AtainEndevor/ARC/ARC Project/20150724_220627.jpg

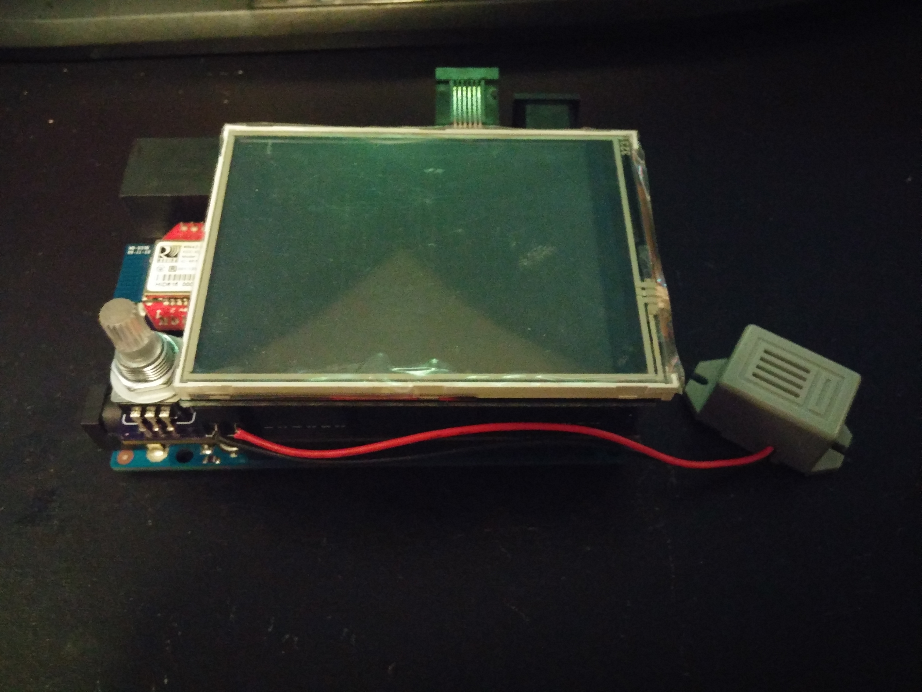
ARC Project/20150724_220627.jpg
