AtainEndevor/ARC/ARC Project/20150724_220816.jpg

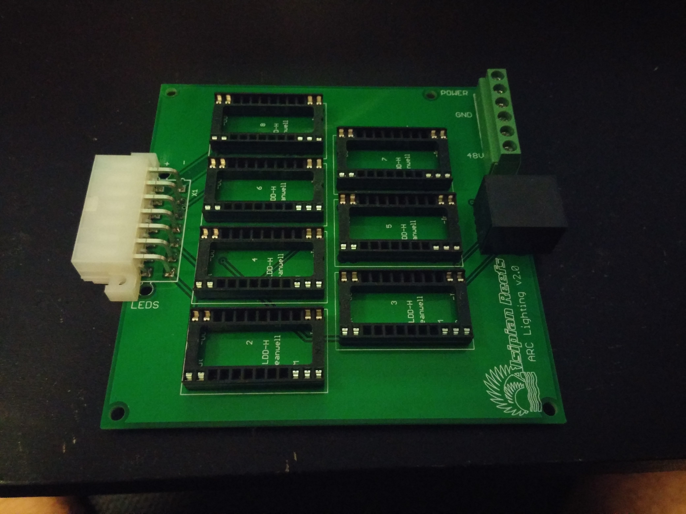
ARC Project/20150724_220816.jpg
