AtainEndevor/ARC/ARC Project/20150724_220504.jpg

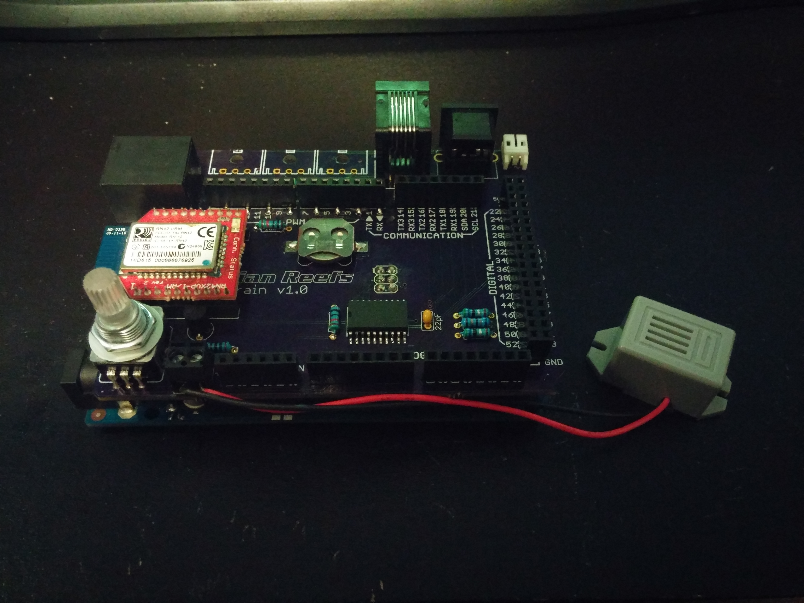
ARC Project/20150724_220504.jpg
