AtainEndevor/ARC/ARC Project/20150724_220649.jpg

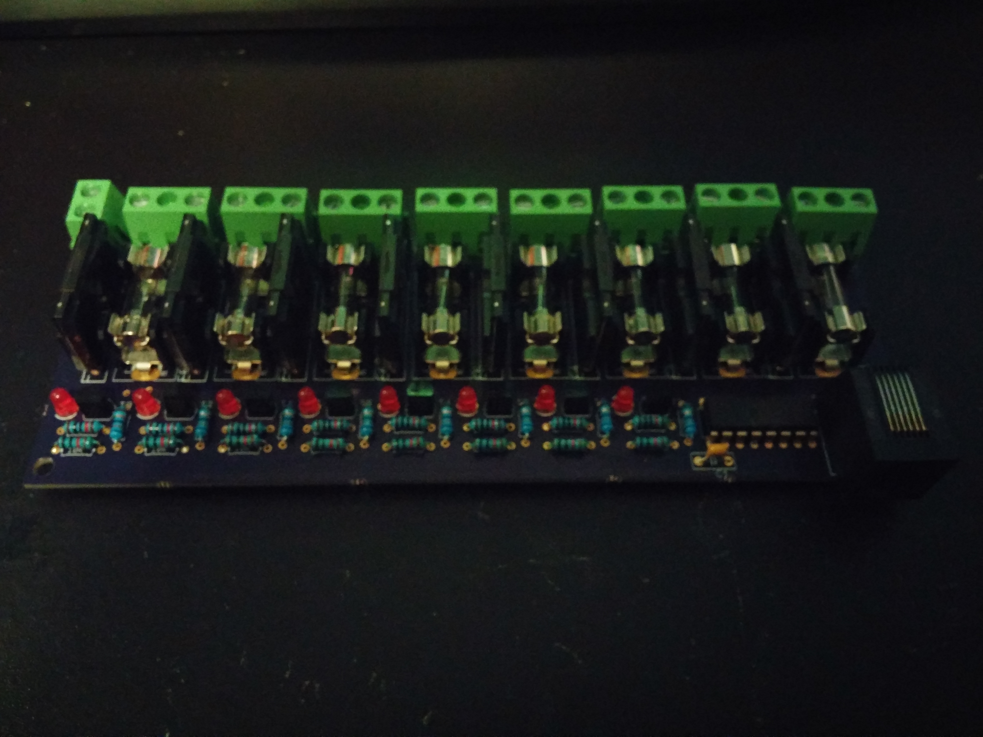
ARC Project/20150724_220649.jpg
