AtainEndevor/ARC/ARC Project/20150724_220824.jpg

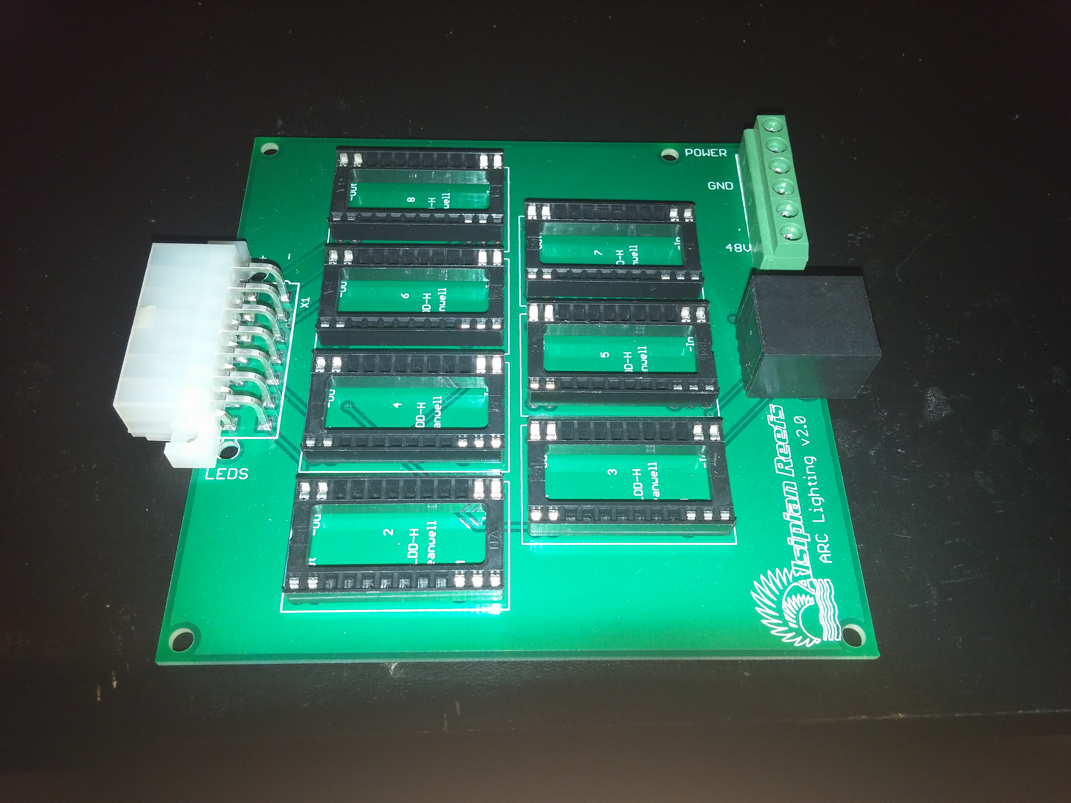
ARC Project/20150724_220824.jpg
