AtainEndevor/ARC/ARC Project/Dosing.png

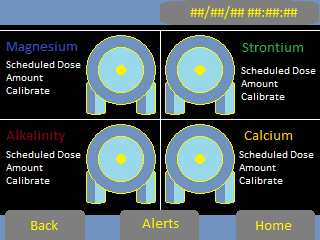
ARC Project/Dosing.png
