AtainEndevor/ARC/ARC Project/Home Page.png

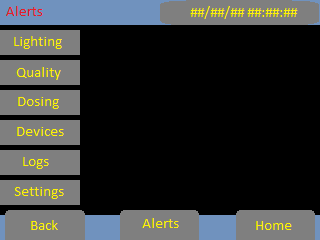
ARC Project/Home Page.png
