AtainEndevor/ARC/ARC Project/Lighting.png

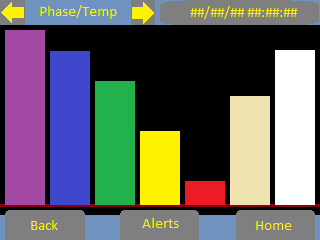
ARC Project/Lighting.png
