AtainEndevor/ARC/ARC Project/Power Outlets.png

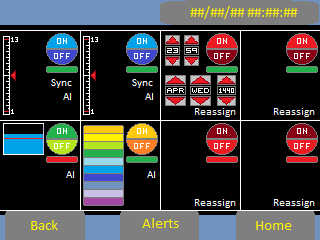
ARC Project/Power Outlets.png
