AtainEndevor/ARC/ARC Project/Quality.png

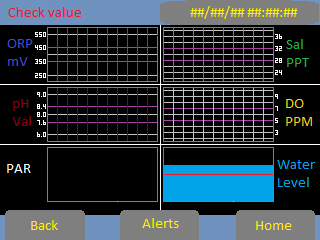
ARC Project/Quality.png
