AtainEndevor/ARC/ARC Project/Template.png

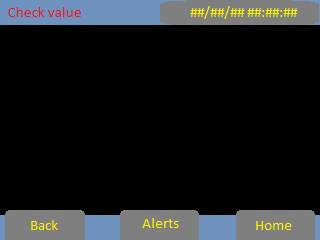
ARC Project/Template.png
