AtainEndevor/ARC/ARC Project/Alsipian_Reefs_Logo.dxf

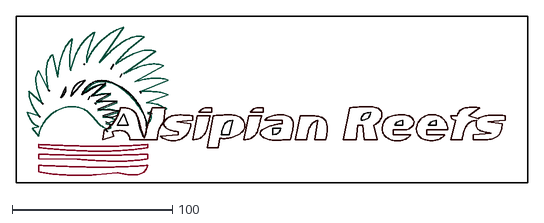
[picture p12: CAD file, 2020-02-04]
ARC Project/Alsipian_Reefs_Logo.dxf
319.0 x 104.0
