AtainEndevor/ARC/ARC Project/Alsipian Reefs Logo-Original (BW).dxf

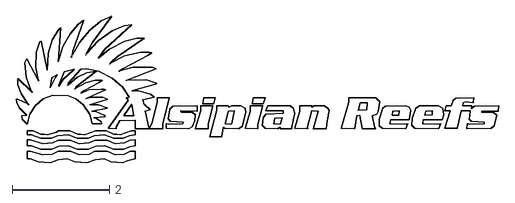
[picture p13: CAD file, 2020-02-04]
ARC Project/Alsipian Reefs Logo-Original (BW).dxf
9.92 x 3.01
