AtainEndevor/ARC/ARC Project/ARC Shield/ARC Shield 0.2.brd

## EAGLE design ARC Project/ARC Shield/ARC Shield 0.2.brd (2020-02-04)

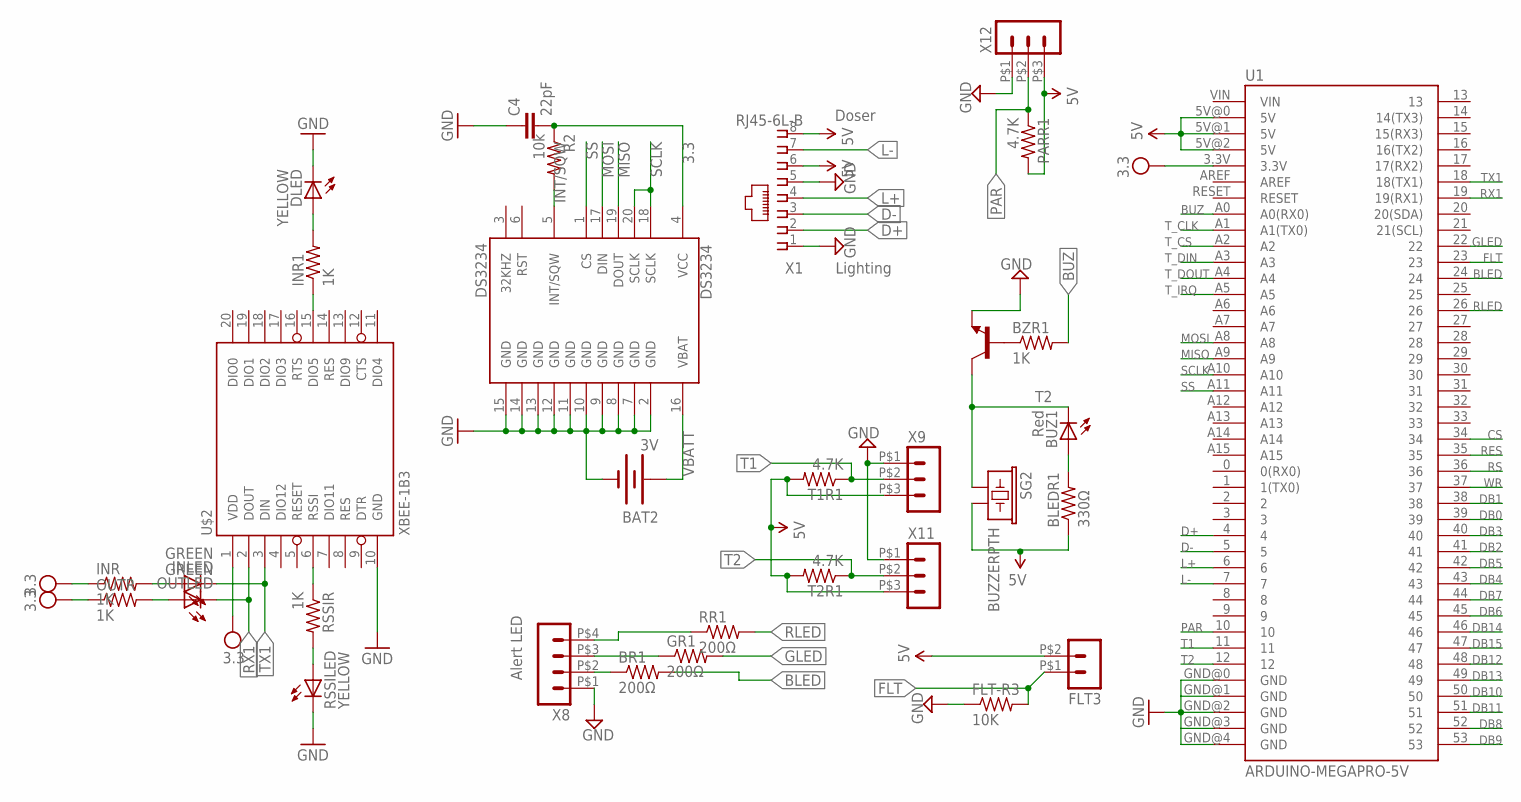
[picture p14: schematic ARC Shield 0.2.sch]

Parts:
BAT2: 3V; BATTCON_12MM_CURVED
BLEDR1: 330Ω; 0204/7
BR1: 200Ω; 0204/7
BUZ1: Red; LED3MM
BZR1: 1K; 0204/7
C4: 22pF; C5B3
DLED: YELLOW; LED3MM
DS3234: DS3234
FLT3: HEADER_POS2_43045-0200; 43045-0200
FLT-R3: 10K; 0204/7
GR1: 200Ω; 0204/7
INLED: GREEN; LED3MM
INR, INR1: 1K; 0204/7
OUTLED: GREEN; LED3MM
OUTR: 1K; 0204/7
PARR1: 4.7K; 0204/7
R2: 10k; 0204/7
RR1: 200Ω; 0204/7
RSSILED: YELLOW; LED3MM
RSSIR: 1K; 0204/7
SG2: BUZZERPTH; BUZZER-12MM
T1R1, T2R1: 4.7K; 0204/7
T2: -NPN-TO92; TO92
U1: ARDUINO-MEGAPRO-5V; ARDUINO_MEGA-PRO-5V
U$2: XBEE-1B3; XBEE-SMD
X1: RJ45-6L-B; RJ45-NO-SHIELD
X8: HEADER_POS4_43045-0401; 43045-0400
X9, X11, X12: HEADER_POS3_43650-0300; 43650-0300

Connections:
3.3: C4.2, DS3234.4 (VCC), R2.1, U$2.1 (VDD)
5V: BLEDR1.1, FLT3.P$2 (2), PARR1.2, SG2.- (2), T1R1.2, T2R1.2, U1.5V@0 (5V), U1.5V@1 (5V), U1.5V@2 (5V), X1.6, X1.8, X9.P$3 (3), X11.P$3 (3), X12.P$3 (3)
BLED: BR1.2, U1.24
BUZ: BZR1.2, U1.A0 (A0(RX0))
CS: U1.34
D+: U1.4, X1.2
D-: U1.5, X1.3
DB0: U1.39
DB1: U1.38
DB2: U1.41
DB3: U1.40
DB4: U1.43
DB5: U1.42
DB6: U1.45
DB7: U1.44
DB8: U1.52
DB9: U1.53
DB10: U1.50
DB11: U1.51
DB12: U1.48
DB13: U1.49
DB14: U1.46
DB15: U1.47
FLT: FLT3.P$1 (1), FLT-R3.2, U1.23
GLED: GR1.2, U1.22
GND: BAT2.GND (-), C4.1, DLED.K (C), DS3234.2 (GND), DS3234.7 (GND), DS3234.8 (GND), DS3234.9 (GND), DS3234.10 (GND), DS3234.11 (GND), DS3234.12 (GND), DS3234.13 (GND), DS3234.14 (GND), DS3234.15 (GND), FLT-R3.1, RSSILED.K (C), T2.1 (E), U1.GND@0 (GND), U1.GND@1 (GND), U1.GND@2 (GND), U1.GND@3 (GND), U1.GND@4 (GND), U$2.10 (GND), X1.1, X1.5, X8.P$1 (1), X9.P$1 (1), X11.P$1 (1), X12.P$1 (1)
INT/SQW: DS3234.5 (INT/SQW), R2.2
L+: U1.6, X1.4
L-: U1.7, X1.7
MISO: DS3234.19 (DOUT), U1.A9
MOSI: DS3234.17 (DIN), U1.A8
unnamed: BR1.1, X8.P$2 (2)
unnamed: BUZ1.K (C), SG2.+ (1), T2.3 (C)
unnamed: BZR1.1, T2.2 (B)
unnamed: RSSIR.1, U$2.6 (RSSI)
unnamed: GR1.1, X8.P$3 (3)
unnamed: RSSILED.A, RSSIR.2
unnamed: RR1.1, X8.P$4 (4)
unnamed: INLED.A, INR.2
unnamed: OUTLED.A, OUTR.2
unnamed: DLED.A, INR1.2
unnamed: INR1.1, U$2.15 (DIO5)
unnamed: BLEDR1.2, BUZ1.A
PAR: PARR1.1, U1.10, X12.P$2 (2)
RES: U1.35
RLED: RR1.2, U1.26
RS: U1.36
RX1: OUTLED.K (C), U1.19 (19(RX1)), U$2.2 (DOUT)
SCLK: DS3234.18 (SCLK), DS3234.20 (SCLK), U1.A10
SS: DS3234.1 (CS), U1.A11
T1: T1R1.1, U1.11, X9.P$2 (2)
T2: T2R1.1, U1.12, X11.P$2 (2)
TX1: INLED.K (C), U1.18 (18(TX1)), U$2.3 (DIN)
T_CLK: U1.A1 (A1(TX0))
T_CS: U1.A2
T_DIN: U1.A3
T_DOUT: U1.A4
T_IRQ: U1.A5
VBATT: BAT2.PWR@1 (+), DS3234.16 (VBAT)
VCC: INR.1, OUTR.1, U1.3.3V
WR: U1.37

Notes on the sheet:
Doser
Alert LED
Lighting

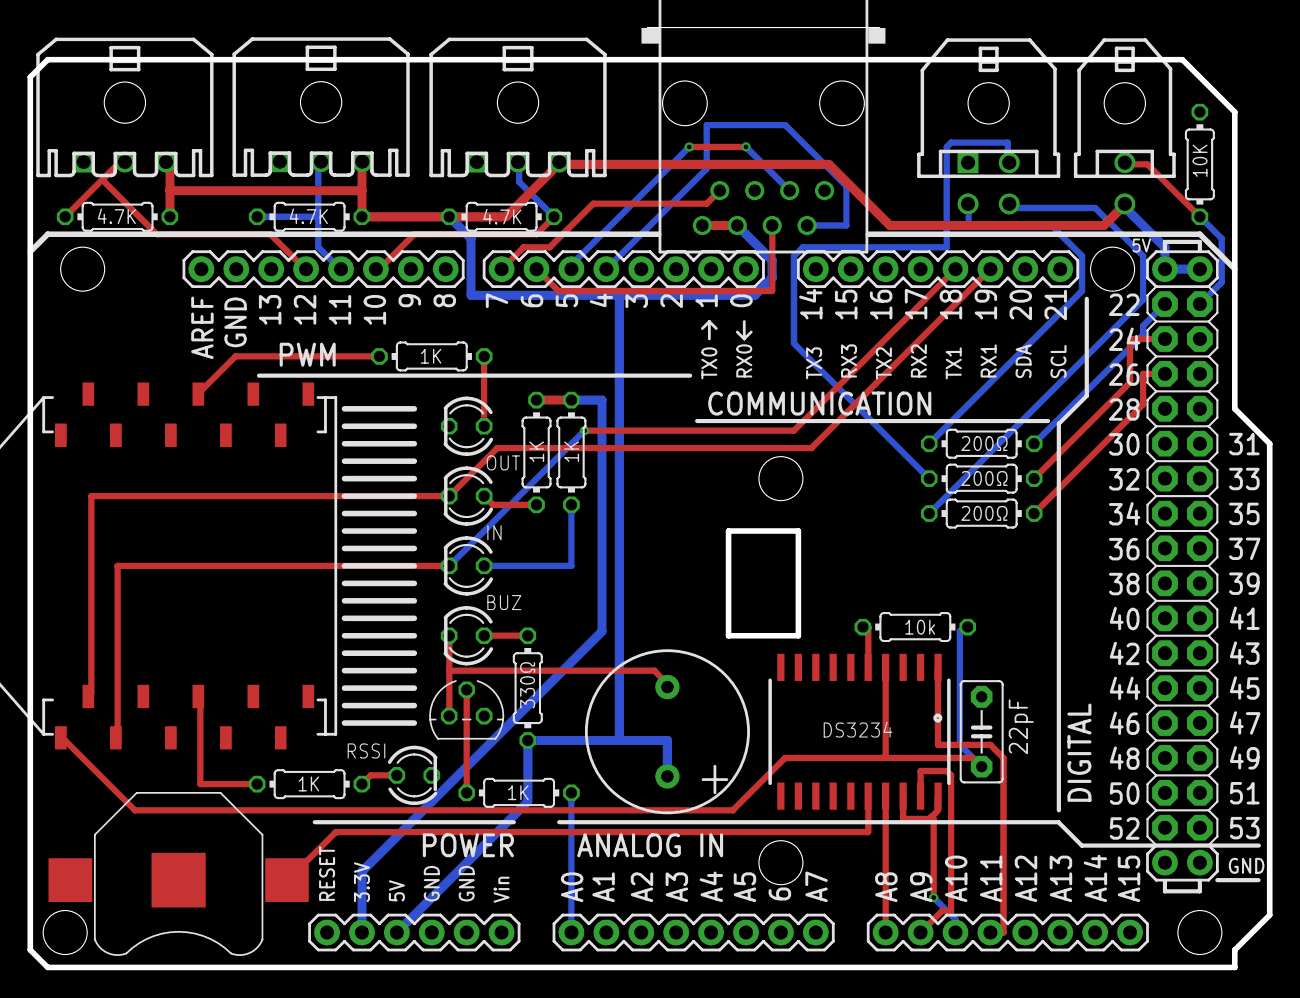
[picture p15: board ARC Shield 0.2.brd from above]

Board: 2 copper layers, 90.2 x 68.4 mm, 32 parts (0 on the bottom side), 36 nets.
