AtainEndevor/ARC/ARC Project/ARC Lighting/ARC Lighting v1.2.brd

## EAGLE design ARC Project/ARC Lighting/ARC Lighting v1.2.brd (2020-02-04)

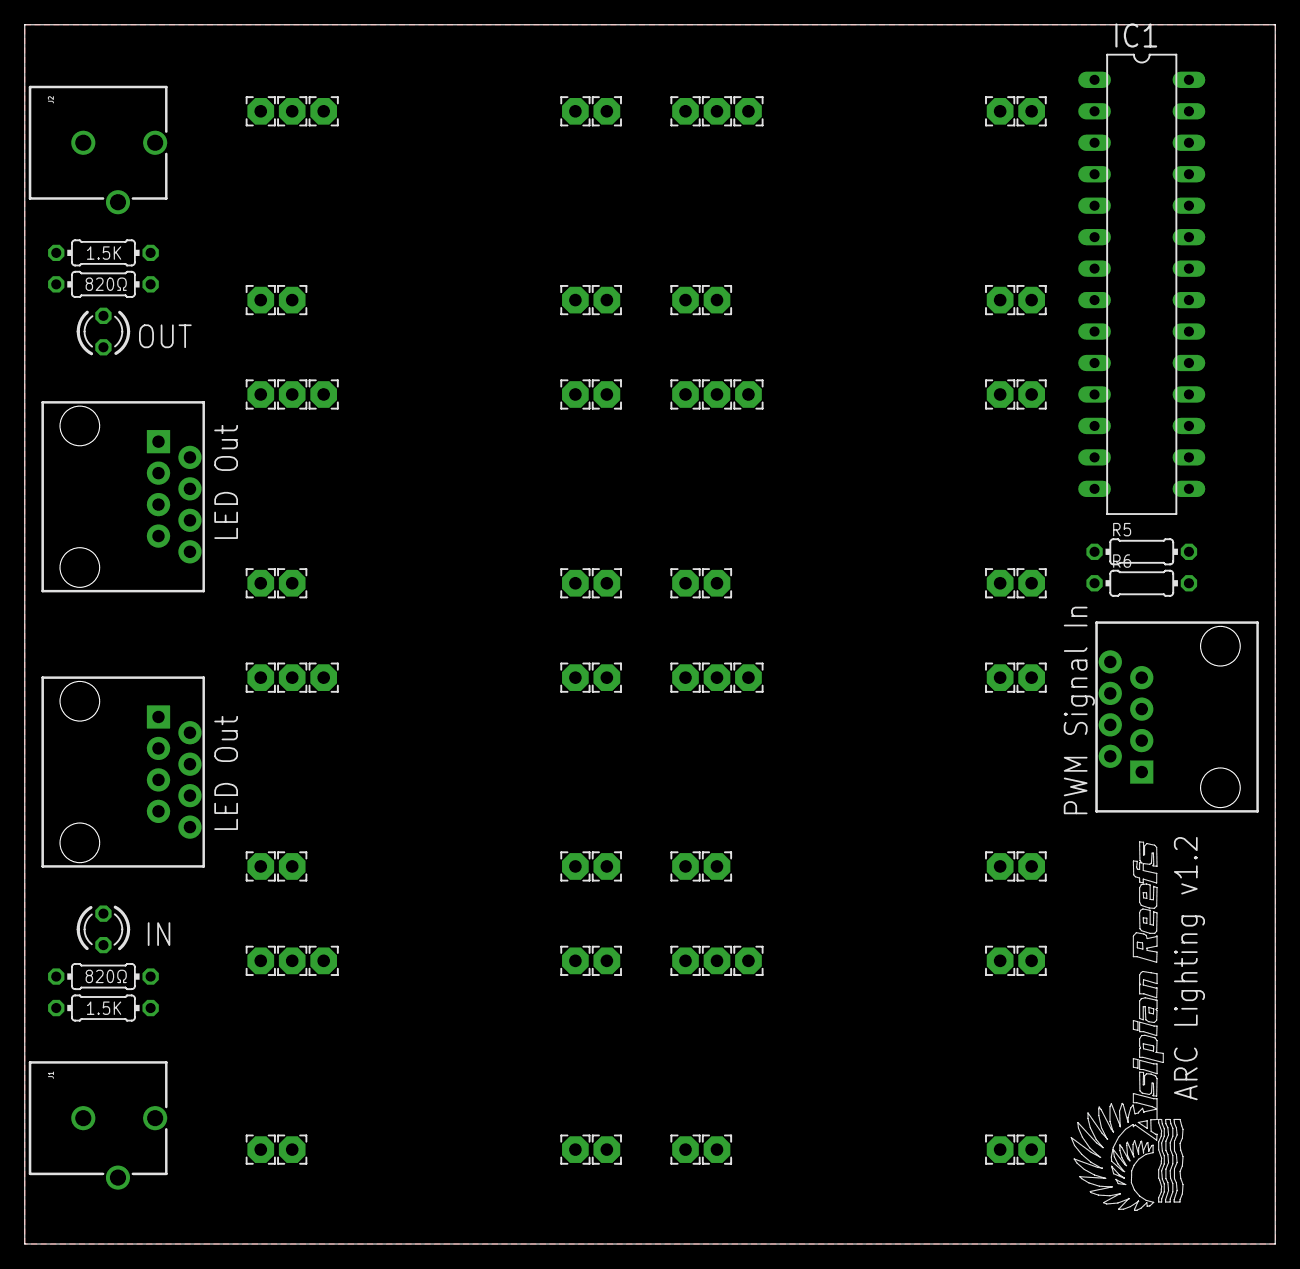
[picture p16: board ARC Lighting v1.2.brd from above]

Board: 2 copper layers, 100.9 x 98.4 mm, 86 parts (0 on the bottom side), 35 nets, no tracks yet.

Parts:
DIM0, DIM1, DIM2, DIM3, DIM4, DIM5, DIM6, DIM7: 2,15/1,0
I+0, I+1, I+2, I+3, I+4, I+5, I+6, I+7: 2,15/1,0
I-0, I-1, I-2, I-3, I-4, I-5, I-6, I-7: 2,15/1,0
IC1: DIP28
J1, J2: Power; POWER_JACK_PTH_BREAD
LED1, LED2: LED3MM
O+0, O+1, O+2, O+3, O+4, O+5, O+6, O+7: 2,15/1,0
O-0, O-1, O-2, O-3, O-4, O-5, O-6, O-7: 2,15/1,0
R1, R3: 1.5K; 0204/7
R2, R4, R5, R6: 820Ω; 0204/7
U$1, U$2, U$3: RJ45-8PTH; RJ45-8
VIN+0, VIN+1, VIN+2, VIN+3, VIN+4, VIN+5, VIN+6, VIN+7: 2,15/1,0
VIN-0, VIN-1, VIN-2, VIN-3, VIN-4, VIN-5, VIN-6, VIN-7: 2,15/1,0
VOUT+0, VOUT+1, VOUT+2, VOUT+3, VOUT+4, VOUT+5, VOUT+6, VOUT+7: 2,15/1,0
VOUT-0, VOUT-1, VOUT-2, VOUT-3, VOUT-4, VOUT-5, VOUT-6, VOUT-7: 2,15/1,0

Connections:
5V: IC1.19, IC1.21, R6.1
12V: I+0.1, I+1.1, I+2.1, I+3.1, I+4.1, I+5.1, I+6.1, I+7.1, J1.PWR, J2.PWR, VIN+0.1, VIN+1.1, VIN+2.1, VIN+3.1, VIN+4.1, VIN+5.1, VIN+6.1, VIN+7.1
GND: I-0.1, I-1.1, I-2.1, I-3.1, I-4.1, I-5.1, I-6.1, I-7.1, IC1.22, J1.GND, J2.GND, LED1.K, LED2.K, R5.1, VIN-0.1, VIN-1.1, VIN-2.1, VIN-3.1, VIN-4.1, VIN-5.1, VIN-6.1, VIN-7.1
L1+: O+1.1, U$2.5, VOUT+1.1
L2+: O+2.1, U$2.4, VOUT+2.1
L2-: O-2.1, U$2.3, VOUT-2.1
L3+: O+3.1, U$2.2, VOUT+3.1
L3-: O-3.1, U$2.1, VOUT-3.1
L4-: O-4.1, U$1.7, VOUT-4.1
L5+: O+5.1, U$1.4, VOUT+5.1
L5-: O-5.1, U$1.3, VOUT-5.1
L6+: O+6.1, U$1.6, VOUT+6.1
L6-: O-6.1, U$1.5, VOUT-6.1
L7+: O+7.1, U$1.2, VOUT+7.1
L7-: O-7.1, U$1.1, VOUT-7.1
LED0: DIM0.1, IC1.1
LED1: DIM1.1, IC1.2
LED2: DIM2.1, IC1.3
LED3: DIM3.1, IC1.4
LED4: DIM4.1, IC1.5
LED5: DIM5.1, IC1.6
LED6: DIM6.1, IC1.7
LED7: DIM7.1, IC1.8
unnamed: J2.GNDBREAK, R1.1
unnamed: R1.2, R2.1
unnamed: LED2.A, R2.2
unnamed: J1.GNDBREAK, R3.1
unnamed: R3.2, R4.1
unnamed: LED1.A, R4.2
unnamed: IC1.23, R6.2
unnamed: IC1.20, R5.2
unnamed: O+4.1, U$1.8, VOUT+4.1
unnamed: O+0.1, U$2.8, VOUT+0.1
unnamed: O-0.1, U$2.7, VOUT-0.1
unnamed: O-1.1, U$2.6, VOUT-1.1
