AtainEndevor/ARC/ARC Project/ARC Shield/ARC Shield 0.1.brd

## EAGLE design ARC Project/ARC Shield/ARC Shield 0.1.brd (2020-02-04)

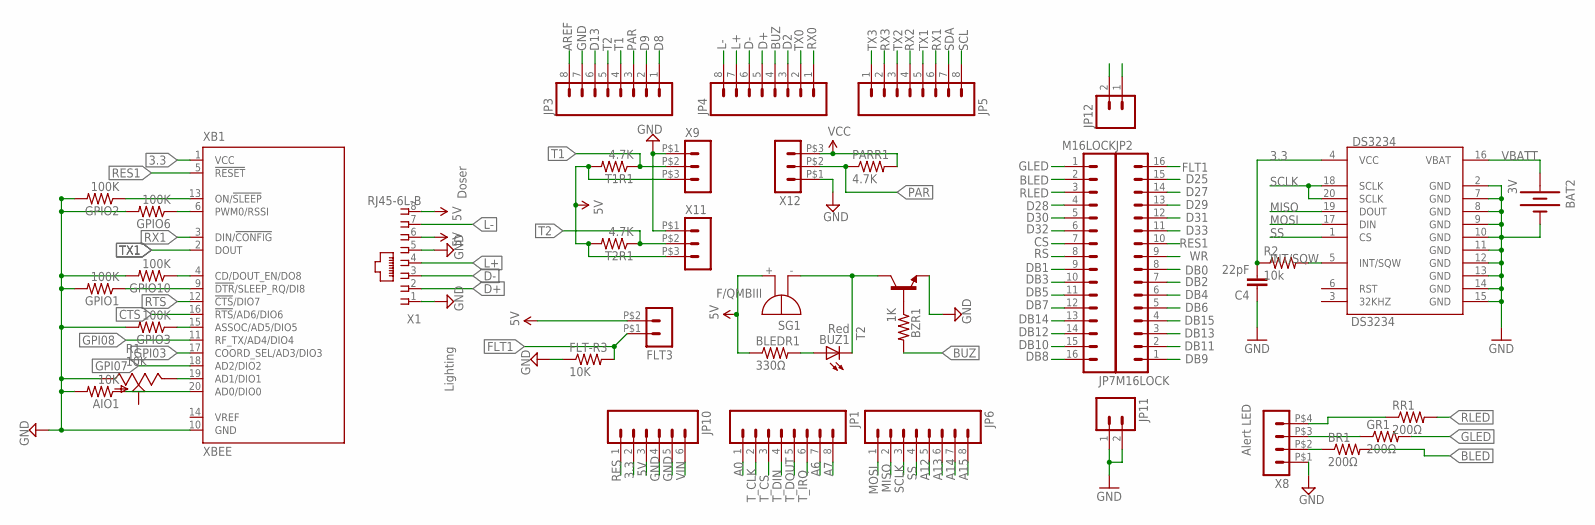
[picture p17: schematic ARC Shield 0.1.sch]

Parts:
AIO1: 10K; 0204/7
BAT2: 3V; BATTCON_12MM_CURVED
BLEDR1: 330Ω; 0204/7
BR1: 200Ω; 0204/7
BUZ1: Red; LED3MM
BZR1: 1K; 0204/7
C4: 22pF; C5B3
DS3234: DS3234
FLT3: HEADER_POS2_43045-0200; 43045-0200
FLT-R3: 10K; 0204/7
GPIO1, GPIO2, GPIO3, GPIO6, GPIO10: 100K; 0204/7
GR1: 200Ω; 0204/7
JP1, JP3, JP4, JP5, JP6: M08LOCK; 1X08_LOCK
JP2, JP7: M16LOCK; 1X16_LOCK
JP10: M06LOCK; 1X06_LOCK
JP11, JP12: M02LOCK; 1X02_LOCK
PARR1: 4.7K; 0204/7
R1: 10K; B25U
R2: 10k; 0204/7
RR1: 200Ω; 0204/7
SG1: F/QMBIII
T1R1, T2R1: 4.7K; 0204/7
T2: -NPN-TO92; TO92
X1: RJ45-6L-B; RJ45-NO-SHIELD
X8: HEADER_POS4_43045-0401; 43045-0400
X9, X11, X12: HEADER_POS3_43650-0300; 43650-0300
XB1: XBEE

Connections:
3.3: C4.2, DS3234.4 (VCC), JP10.2, R2.1, XB1.1 (VCC)
5V: BLEDR1.1, FLT3.P$2 (2), JP10.3, PARR1.2, SG1.+ (-), T1R1.2, T2R1.2, X1.6, X1.8, X9.P$3 (3), X11.P$3 (3), X12.P$3 (3)
5V@1: JP12.1, JP12.2
A0: JP1.1
A6: JP1.7
A7: JP1.8
A12: JP6.5
A13: JP6.6
A14: JP6.7
A15: JP6.8
AREF: JP3.8
BLED: BR1.2, JP7.2
BUZ: BZR1.2, JP4.4
CS: JP7.7
CTS: XB1.16 (!RTS!/AD6/DIO6)
D2: JP4.3
D8: JP3.1
D9: JP3.2
D13: JP3.6
D25: JP2.15
D27: JP2.14
D28: JP7.4
D29: JP2.13
D30: JP7.5
D31: JP2.12
D32: JP7.6
D33: JP2.11
D+: JP4.5, X1.2
D-: JP4.6, X1.3
DB0: JP2.8
DB1: JP7.9
DB2: JP2.7
DB3: JP7.10
DB4: JP2.6
DB5: JP7.11
DB6: JP2.5
DB7: JP7.12
DB8: JP7.16
DB9: JP2.1
DB10: JP7.15
DB11: JP2.2
DB12: JP7.14
DB13: JP2.3
DB14: JP7.13
DB15: JP2.4
FLT1: FLT3.P$1 (1), FLT-R3.2, JP2.16
GLED: GR1.2, JP7.1
GND: AIO1.2, BAT2.GND (-), C4.1, DS3234.2 (GND), DS3234.7 (GND), DS3234.8 (GND), DS3234.9 (GND), DS3234.10 (GND), DS3234.11 (GND), DS3234.12 (GND), DS3234.13 (GND), DS3234.14 (GND), DS3234.15 (GND), FLT-R3.1, GPIO1.2, GPIO2.2, GPIO3.2, GPIO6.2, GPIO10.2, JP3.7, JP10.4, JP10.5, JP11.1, JP11.2, R1.A, T2.1 (E), X1.1, X1.5, X8.P$1 (1), X9.P$1 (1), X11.P$1 (1), X12.P$1 (1), XB1.10 (GND)
GPI03: XB1.17 (COORD_SEL/AD3/DIO3)
GPI07: XB1.18 (AD2/DIO2)
GPI08: XB1.11 (RF_TX/AD4/DIO4)
INT/SQW: DS3234.5 (INT/SQW), R2.2
L+: JP4.7, X1.4
L-: JP4.8, X1.7
MISO: DS3234.19 (DOUT), JP6.2
MOSI: DS3234.17 (DIN), JP6.1
unnamed: BR1.1, X8.P$2 (2)
unnamed: BUZ1.K (C), SG1.- (+), T2.3 (C)
unnamed: BZR1.1, T2.2 (B)
unnamed: R1.E, XB1.19 (AD1/DIO1)
unnamed: GR1.1, X8.P$3 (3)
unnamed: RR1.1, X8.P$4 (4)
unnamed: GPIO10.1, XB1.4 (CD/DOUT_EN/DO8)
unnamed: GPIO2.1, XB1.13 (ON/!SLEEP)
unnamed: GPIO6.1, XB1.6 (PWM0/RSSI)
unnamed: GPIO1.1, XB1.9 (!DTR!/SLEEP_RQ/DI8)
unnamed: GPIO3.1, XB1.15 (ASSOC/AD5/DIO5)
unnamed: BLEDR1.2, BUZ1.A
unnamed: AIO1.1, XB1.20 (AD0/DIO0)
PAR: JP3.3, PARR1.1, X12.P$2 (2)
RES: JP10.1
RES1: JP2.10, XB1.5 (!RESET)
RLED: JP7.3, RR1.2
RS: JP7.8
RTS: XB1.12 (!CTS!/DIO7)
RX0: JP4.1
RX1: JP5.6, XB1.3 (DIN/!CONFIG)
RX2: JP5.4
RX3: JP5.2
SCL: JP5.8
SCLK: DS3234.18 (SCLK), DS3234.20 (SCLK), JP6.3
SDA: JP5.7
SS: DS3234.1 (CS), JP6.4
T1: JP3.4, T1R1.1, X9.P$2 (2)
T2: JP3.5, T2R1.1, X11.P$2 (2)
TX0: JP4.2
TX1: JP5.5, XB1.2 (DOUT)
TX2: JP5.3
TX3: JP5.1
T_CLK: JP1.2
T_CS: JP1.3
T_DIN: JP1.4
T_DOUT: JP1.5
T_IRQ: JP1.6
VBATT: BAT2.PWR@1 (+), DS3234.16 (VBAT)
VIN: JP10.6
WR: JP2.9

Notes on the sheet:
Doser
Alert LED
Lighting

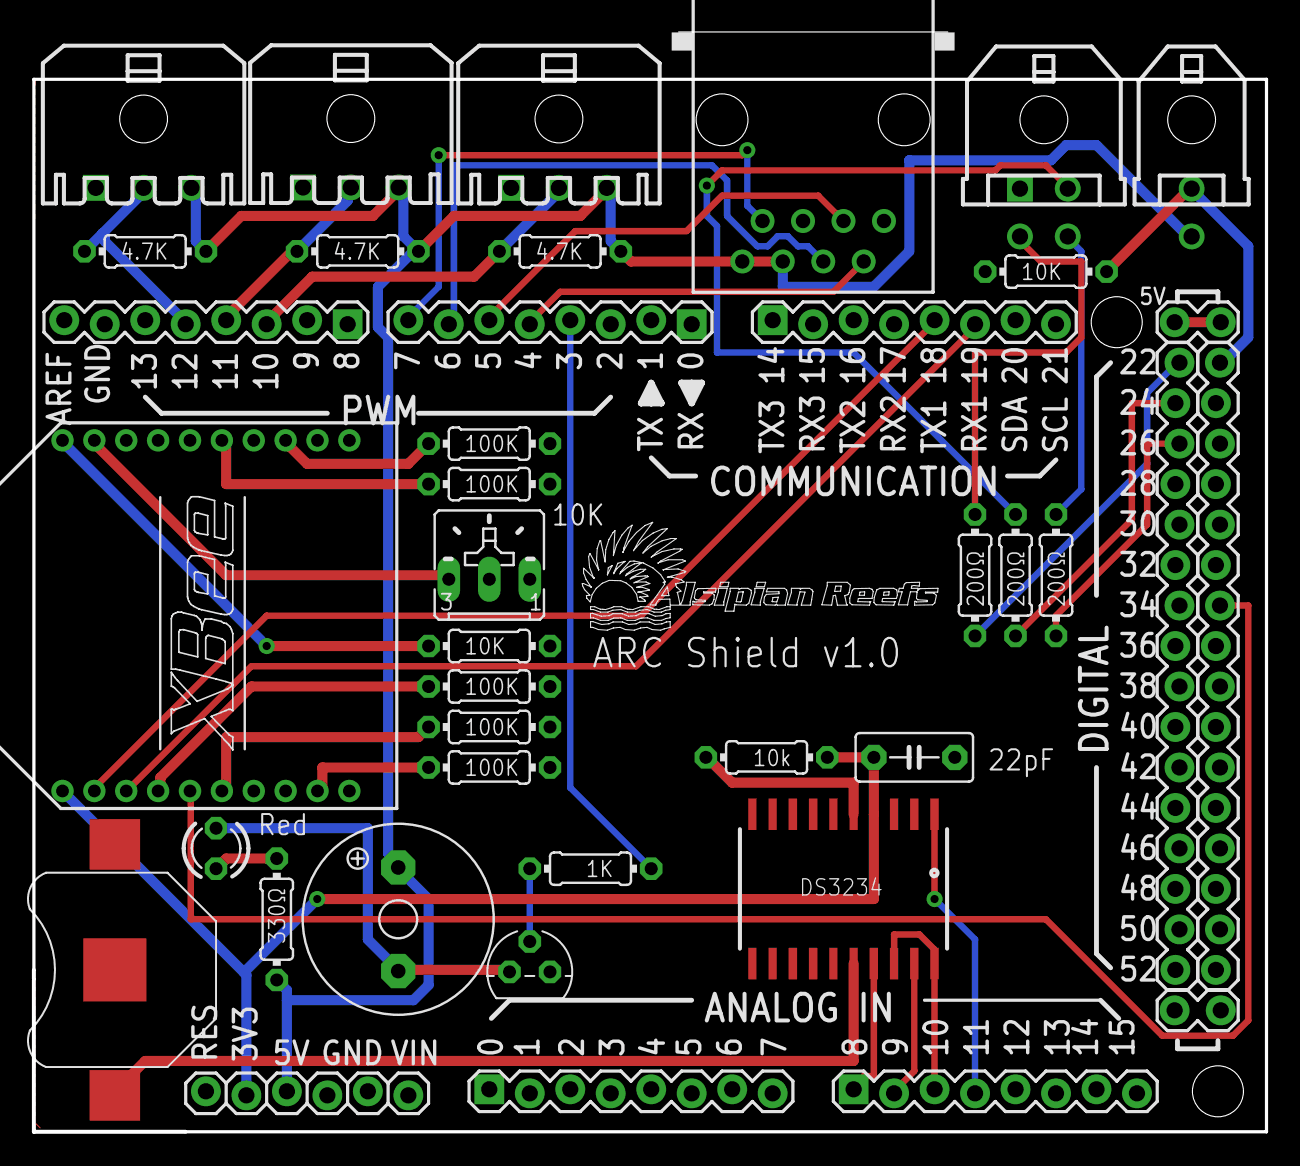
[picture p18: board ARC Shield 0.1.brd from above]

Board: 2 copper layers, 77.3 x 69.0 mm, 40 parts (0 on the bottom side), 38 nets.
