AtainEndevor/ARC/ARC Project/ARC Power/ARC Power v0.1.brd

## EAGLE design ARC Project/ARC Power/ARC Power v0.1.brd (2020-02-04)

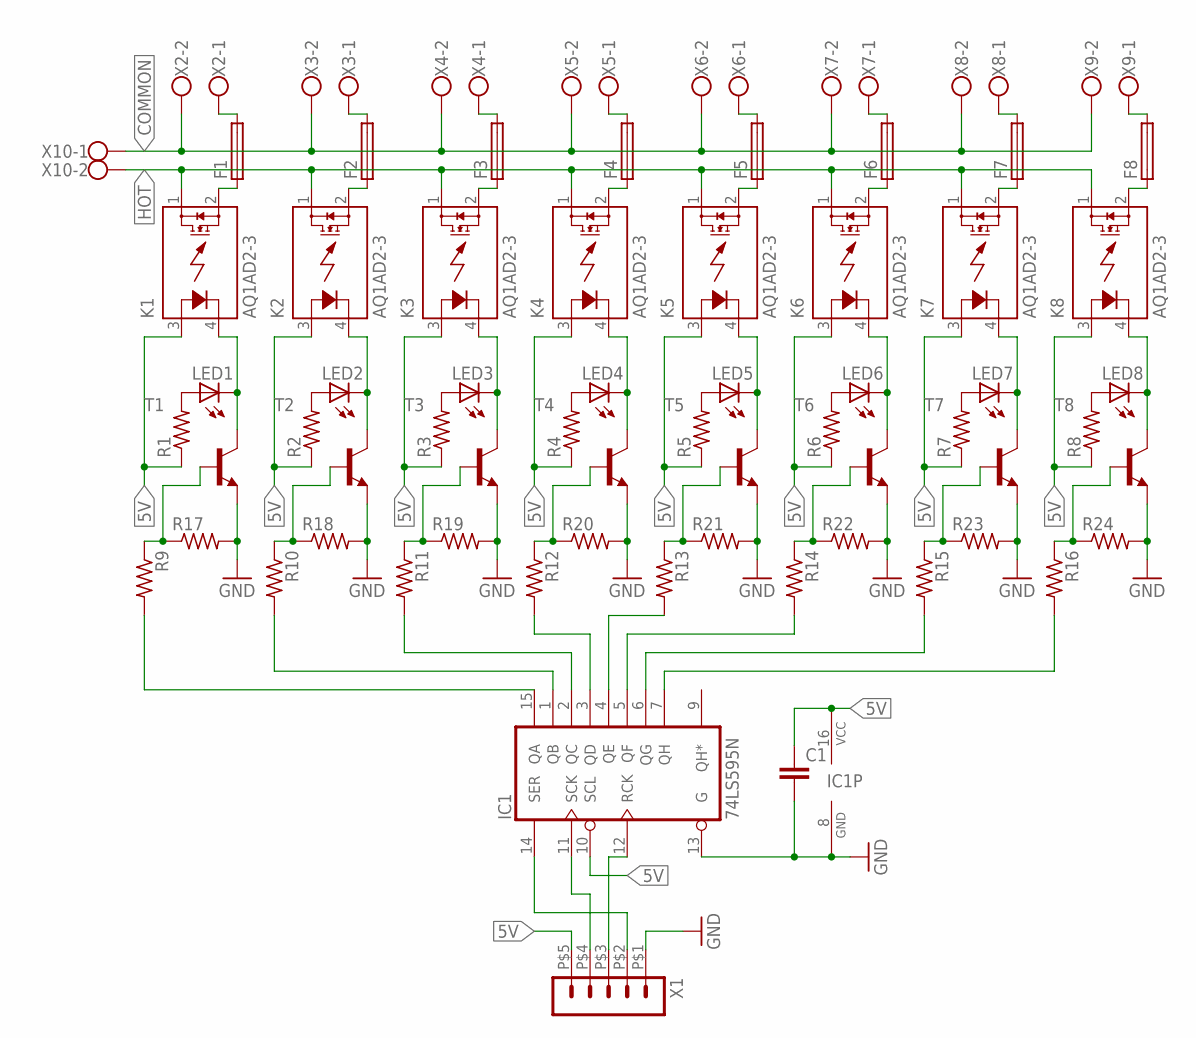
[picture p19: schematic ARC Power v0.1.sch]

Parts:
C1: C5/3; C5B3
F1, F2, F3, F4, F5, F6, F7, F8: SH22,5A
IC1: 74LS595N; DIL16
K1, K2, K3, K4, K5, K6, K7, K8: AQ1AD2-3; AQ1
LED1, LED2, LED3, LED4, LED5, LED6, LED7, LED8: LED3MM
R1, R2, R3, R4, R5, R6, R7, R8, R9, R10, R11, R12, R13, R14, R15, R16, R17, R18, R19, R20, R21, R22, R23, R24: R-US_0204/7; 0204/7
T1, T2, T3, T4, T5, T6, T7, T8: -NPN-TO92; TO92
X1: HEADER_POS5_43650-0500; 43650-0500
X2, X3, X4, X5, X6, X7, X8, X9: W237-113
X10: W237-102

Connections:
5V: C1.1, IC1.10 (SCL), IC1.16 (VCC), K1.3 (A), K2.3 (A), K3.3 (A), K4.3 (A), K5.3 (A), K6.3 (A), K7.3 (A), K8.3 (A), R1.1, R2.1, R3.1, R4.1, R5.1, R6.1, R7.1, R8.1, X1.P$5 (5)
COMMON: X2.2, X3.2, X4.2, X5.2, X6.2, X7.2, X8.2, X9.2, X10.1
GND: C1.2, IC1.8 (GND), IC1.13 (G), R17.2, R18.2, R19.2, R20.2, R21.2, R22.2, R23.2, R24.2, T1.1 (E), T2.1 (E), T3.1 (E), T4.1 (E), T5.1 (E), T6.1 (E), T7.1 (E), T8.1 (E), X1.P$1 (1)
HOT: K1.1 (DS1), K2.1 (DS1), K3.1 (DS1), K4.1 (DS1), K5.1 (DS1), K6.1 (DS1), K7.1 (DS1), K8.1 (DS1), X10.2
unnamed: IC1.15 (QA), R9.2
unnamed: IC1.1 (QB), R10.2
unnamed: IC1.2 (QC), R11.2
unnamed: IC1.3 (QD), R12.2
unnamed: IC1.4 (QE), R13.2
unnamed: IC1.5 (QF), R14.2
unnamed: IC1.6 (QG), R15.2
unnamed: IC1.7 (QH), R16.2
unnamed: F1.1, K1.2 (DS2)
unnamed: F1.2, X2.1
unnamed: F2.1, K2.2 (DS2)
unnamed: F2.2, X3.1
unnamed: F3.1, K3.2 (DS2)
unnamed: F3.2, X4.1
unnamed: F4.1, K4.2 (DS2)
unnamed: F4.2, X5.1
unnamed: F5.1, K5.2 (DS2)
unnamed: IC1.14 (SER), X1.P$2 (2)
unnamed: IC1.12 (RCK), X1.P$3 (3)
unnamed: IC1.11 (SCK), X1.P$4 (4)
unnamed: F5.2, X6.1
unnamed: F6.1, K6.2 (DS2)
unnamed: F6.2, X7.1
unnamed: F7.1, K7.2 (DS2)
unnamed: F7.2, X8.1
unnamed: F8.1, K8.2 (DS2)
unnamed: F8.2, X9.1
unnamed: LED1.A, R1.2
unnamed: LED2.A, R2.2
unnamed: LED3.A, R3.2
unnamed: LED4.A, R4.2
unnamed: LED5.A, R5.2
unnamed: LED6.A, R6.2
unnamed: LED7.A, R7.2
unnamed: LED8.A, R8.2
unnamed: K1.4 (K), LED1.K (C), T1.3 (C)
unnamed: K2.4 (K), LED2.K (C), T2.3 (C)
unnamed: K3.4 (K), LED3.K (C), T3.3 (C)
unnamed: K4.4 (K), LED4.K (C), T4.3 (C)
unnamed: K5.4 (K), LED5.K (C), T5.3 (C)
unnamed: K6.4 (K), LED6.K (C), T6.3 (C)
unnamed: K7.4 (K), LED7.K (C), T7.3 (C)
unnamed: K8.4 (K), LED8.K (C), T8.3 (C)
unnamed: R9.1, R17.1, T1.2 (B)
unnamed: R10.1, R18.1, T2.2 (B)
unnamed: R11.1, R19.1, T3.2 (B)
unnamed: R12.1, R20.1, T4.2 (B)
unnamed: R13.1, R21.1, T5.2 (B)
unnamed: R14.1, R22.1, T6.2 (B)
unnamed: R15.1, R23.1, T7.2 (B)
unnamed: R16.1, R24.1, T8.2 (B)

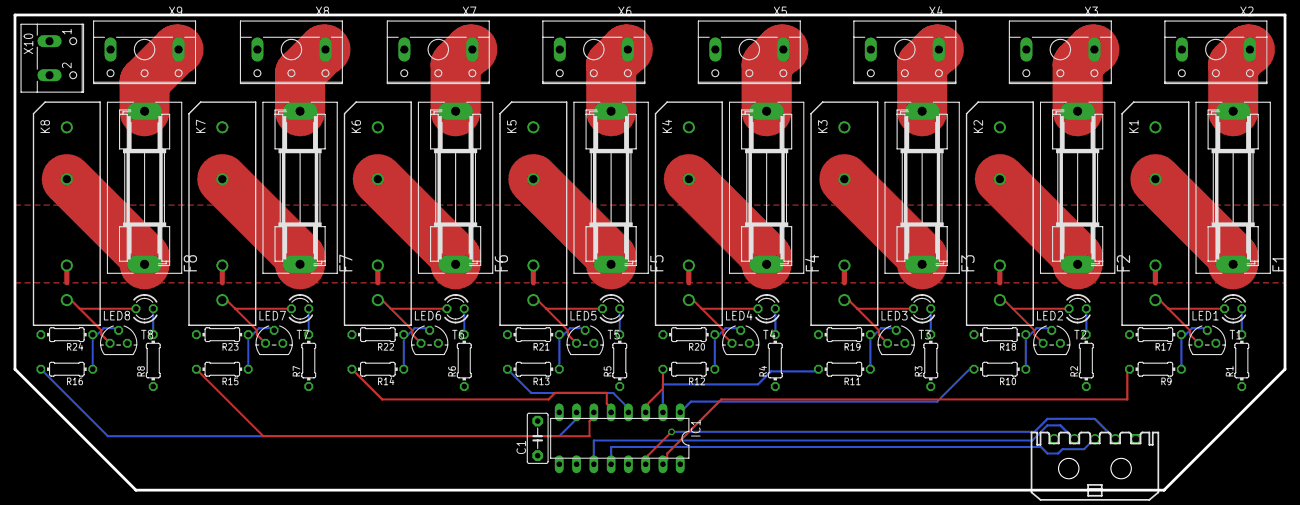
[picture p20: board ARC Power v0.1.brd from above]

Board: 2 copper layers, 186.7 x 69.9 mm, 68 parts (0 on the bottom side), 55 nets.
