AtainEndevor/ARC/ARC Project/ARC Doser/ARC Doser.brd

## EAGLE design ARC Project/ARC Doser/ARC Doser.brd (2020-02-04)

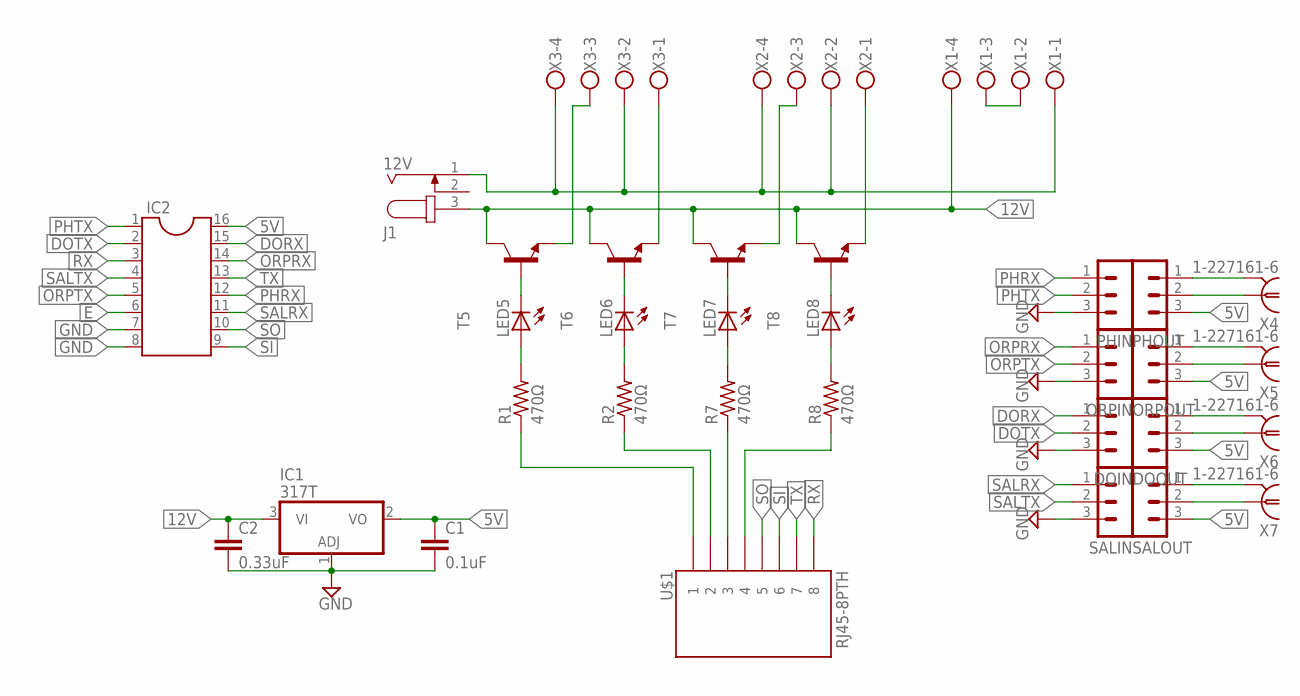
[picture p21: schematic ARC Doser.sch]

Parts:
C1: 0.1uF; C5B3
C2: 0.33uF; C5B3
DOIN: MA03-1
DOOUT: MA03-1
IC1: 317T; TO220H
IC2: DIL16
J1: 12V; SPC4077
LED5, LED6, LED7, LED8: LED3MM
ORPIN: MA03-1
ORPOUT: MA03-1
PHIN: MA03-1
PHOUT: MA03-1
R1, R2, R7, R8: 470Ω; 0204/7
SALIN: MA03-1
SALOUT: MA03-1
T5, T6, T7, T8: -NPN-TO92; TO92
U$1: RJ45-8PTH; RJ45-8
X1, X2, X3: W237-4
X4, X5, X6, X7: 1-227161-6; AMP_227161

Connections:
5V: C1.1, DOOUT.3, IC1.2 (VO), IC2.16, ORPOUT.3, PHOUT.3, SALOUT.3
12V: C2.1, IC1.3 (VI), J1.3, T5.3 (C), T6.3 (C), T7.3 (C), T8.3 (C), X1.4
DORX: DOIN.1, IC2.15
DOTX: DOIN.2, IC2.2
E: IC2.6
GND: C1.2, C2.2, DOIN.3, IC1.1 (ADJ), IC2.7, IC2.8, J1.1, ORPIN.3, PHIN.3, SALIN.3, X1.1, X2.2, X2.4, X3.2, X3.4
unnamed: R7.1, U$1.3
unnamed: T5.1 (E), X3.3
unnamed: T6.1 (E), X3.1
unnamed: R8.1, U$1.4
unnamed: LED5.A, R1.2
unnamed: R2.1, U$1.2
unnamed: R1.1, U$1.1
unnamed: T7.1 (E), X2.3
unnamed: T8.1 (E), X2.1
unnamed: PHOUT.1, X4.2
unnamed: ORPOUT.1, X5.2
unnamed: LED5.K (C), T5.2 (B)
unnamed: LED6.A, R2.2
unnamed: DOOUT.1, X6.2
unnamed: SALOUT.1, X7.2
unnamed: PHOUT.2, X4.1
unnamed: X1.2, X1.3
unnamed: ORPOUT.2, X5.1
unnamed: DOOUT.2, X6.1
unnamed: SALOUT.2, X7.1
unnamed: LED6.K (C), T6.2 (B)
unnamed: LED7.A, R7.2
unnamed: LED7.K (C), T7.2 (B)
unnamed: LED8.K (C), T8.2 (B)
unnamed: LED8.A, R8.2
ORPRX: IC2.14, ORPIN.1
ORPTX: IC2.5, ORPIN.2
PHRX: IC2.12, PHIN.1
PHTX: IC2.1, PHIN.2
RX: IC2.3, U$1.8
SALRX: IC2.11, SALIN.1
SALTX: IC2.4, SALIN.2
SI: IC2.9, U$1.6
SO: IC2.10, U$1.5
TX: IC2.13, U$1.7

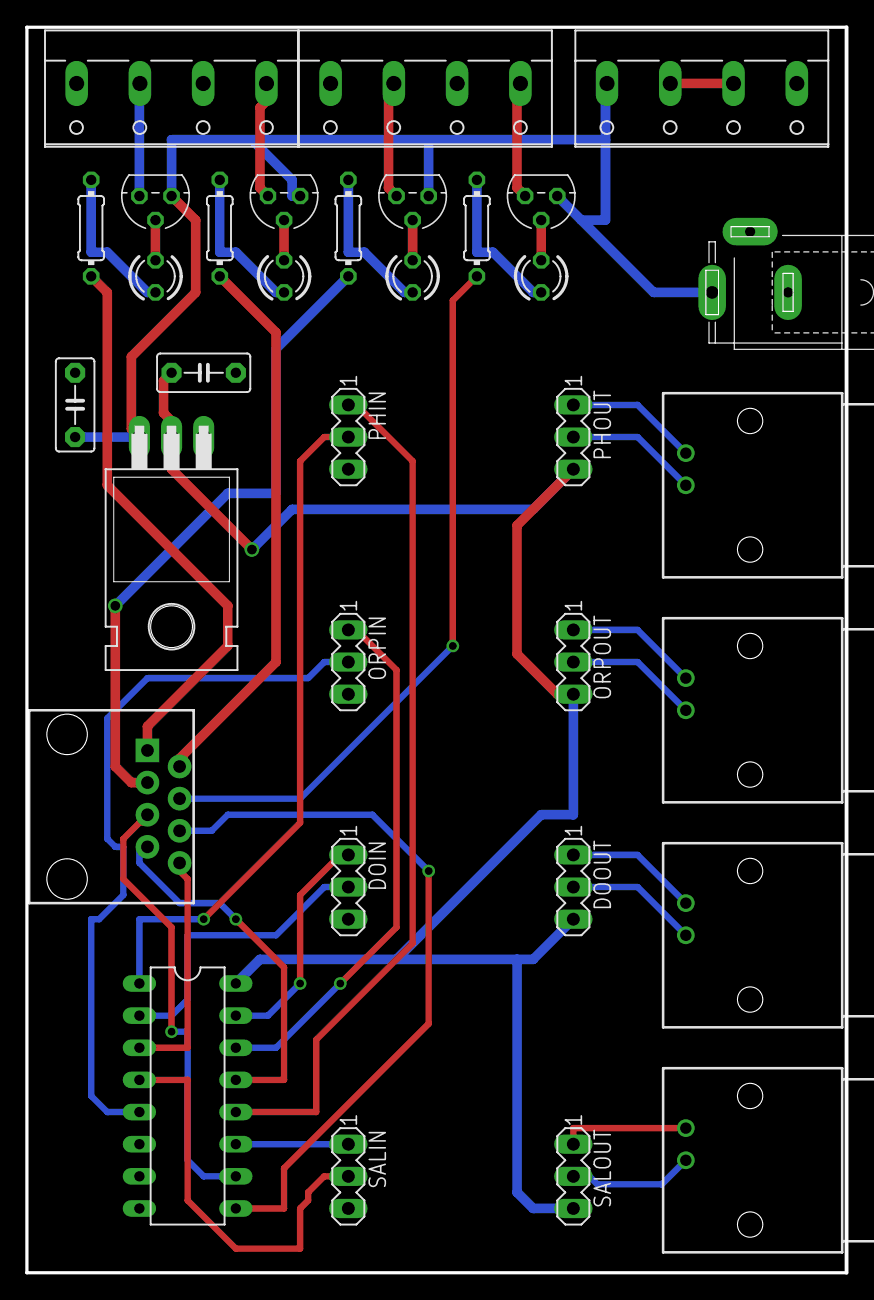
[picture p22: board ARC Doser.brd from above]

Board: 2 copper layers, 64.8 x 98.4 mm, 33 parts (0 on the bottom side), 40 nets.
