AtainEndevor/ARC/ARC Project/ARC Lighting/ARC Lighting v1.0.brd

## EAGLE design ARC Project/ARC Lighting/ARC Lighting v1.0.brd (2020-02-04, an earlier design)

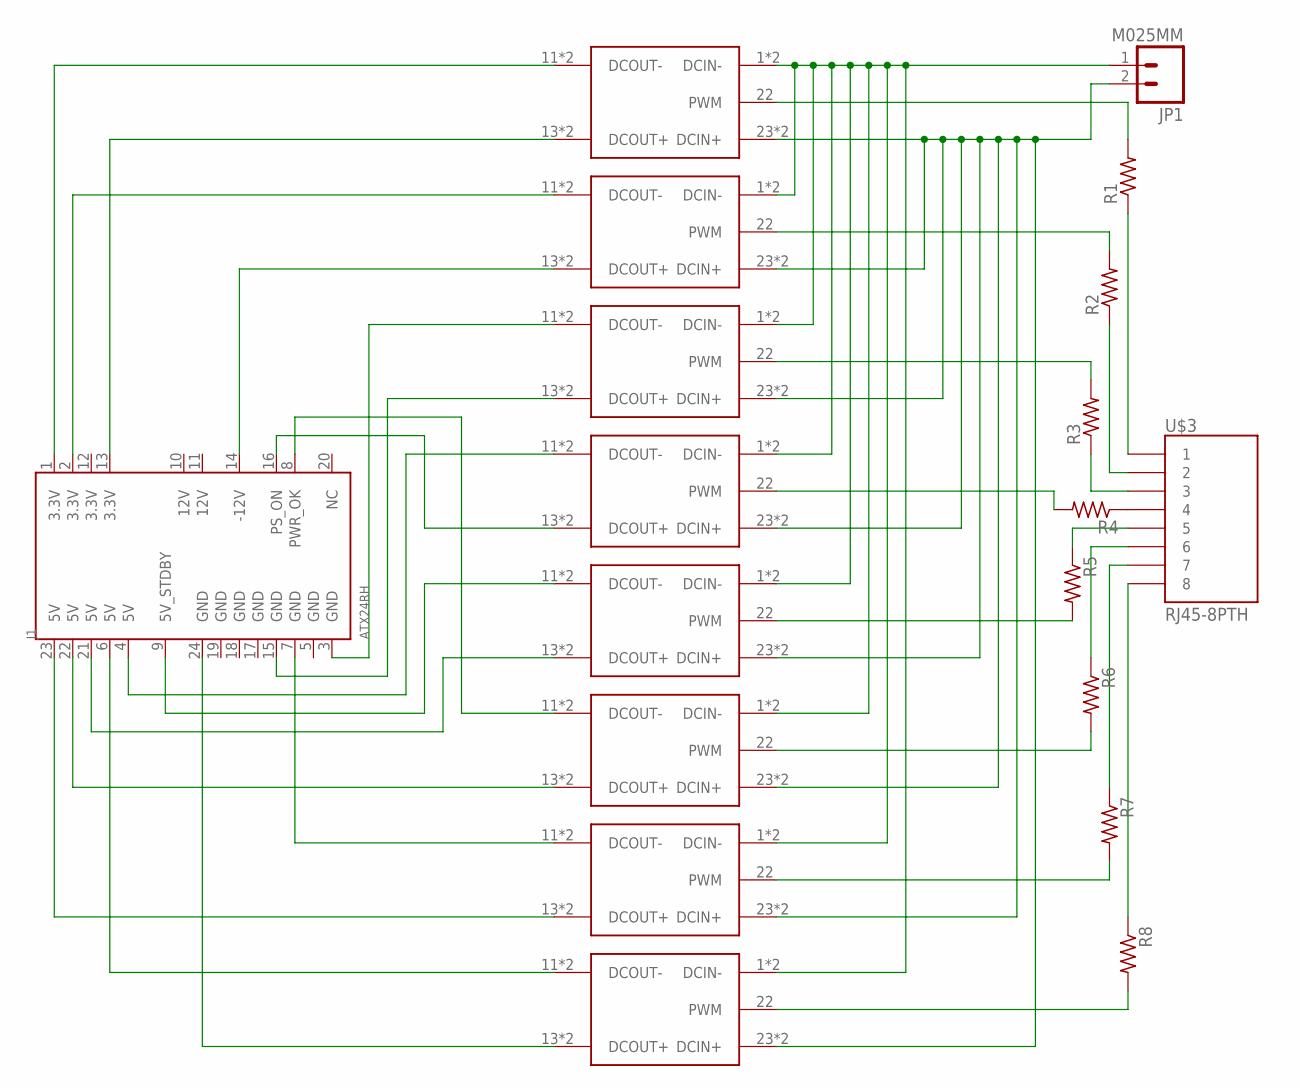
[picture p23: schematic ARC Lighting v1.0.sch]

Parts:
J1: ATX24RH; ATX24_RIGHT_ANGLE
JP1: M025MM; SCREWTERMINAL-5MM-2
R1, R2, R3, R4, R5, R6, R7, R8: R-US_0204/7; 0204/7
U$1: 1; LDD_H
U$2: 2; LDD_H
U$3: RJ45-8PTH; RJ45-8
U$4: 3; LDD_H
U$5: 4; LDD_H
U$6: 5; LDD_H
U$7: 6; LDD_H
U$8: 7; LDD_H
U$9: 8; LDD_H

Connections:
unnamed: J1.13 (3.3V), U$1.13 (DCOUT+), U$1.14 (DCOUT+)
unnamed: R2.2, U$2.22 (PWM)
unnamed: R3.2, U$4.22 (PWM)
unnamed: R4.1, U$3.4
unnamed: R8.2, U$9.22 (PWM)
unnamed: R7.2, U$8.22 (PWM)
unnamed: R6.2, U$7.22 (PWM)
unnamed: R5.2, U$6.22 (PWM)
unnamed: J1.1 (3.3V), U$1.11 (DCOUT-), U$1.12 (DCOUT-)
unnamed: JP1.1, U$1.1 (DCIN-), U$1.2 (DCIN-), U$2.1 (DCIN-), U$2.2 (DCIN-), U$4.1 (DCIN-), U$4.2 (DCIN-), U$5.1 (DCIN-), U$5.2 (DCIN-), U$6.1 (DCIN-), U$6.2 (DCIN-), U$7.1 (DCIN-), U$7.2 (DCIN-), U$8.1 (DCIN-), U$8.2 (DCIN-), U$9.1 (DCIN-), U$9.2 (DCIN-)
unnamed: JP1.2, U$1.23 (DCIN+), U$1.24 (DCIN+), U$2.23 (DCIN+), U$2.24 (DCIN+), U$4.23 (DCIN+), U$4.24 (DCIN+), U$5.23 (DCIN+), U$5.24 (DCIN+), U$6.23 (DCIN+), U$6.24 (DCIN+), U$7.23 (DCIN+), U$7.24 (DCIN+), U$8.23 (DCIN+), U$8.24 (DCIN+), U$9.23 (DCIN+), U$9.24 (DCIN+)
unnamed: J1.2 (3.3V), U$2.11 (DCOUT-), U$2.12 (DCOUT-)
unnamed: J1.14 (-12V), U$2.13 (DCOUT+), U$2.14 (DCOUT+)
unnamed: J1.3 (GND), U$4.11 (DCOUT-), U$4.12 (DCOUT-)
unnamed: J1.15 (GND), U$4.13 (DCOUT+), U$4.14 (DCOUT+)
unnamed: J1.4 (5V), U$5.11 (DCOUT-), U$5.12 (DCOUT-)
unnamed: J1.16 (PS_ON), U$5.13 (DCOUT+), U$5.14 (DCOUT+)
unnamed: J1.9 (5V_STDBY), U$6.11 (DCOUT-), U$6.12 (DCOUT-)
unnamed: J1.21 (5V), U$6.13 (DCOUT+), U$6.14 (DCOUT+)
unnamed: J1.8 (PWR_OK), U$7.11 (DCOUT-), U$7.12 (DCOUT-)
unnamed: J1.22 (5V), U$7.13 (DCOUT+), U$7.14 (DCOUT+)
unnamed: J1.7 (GND), U$8.11 (DCOUT-), U$8.12 (DCOUT-)
unnamed: J1.23 (5V), U$8.13 (DCOUT+), U$8.14 (DCOUT+)
unnamed: J1.6 (5V), U$9.11 (DCOUT-), U$9.12 (DCOUT-)
unnamed: J1.24 (GND), U$9.13 (DCOUT+), U$9.14 (DCOUT+)
unnamed: R2.1, U$3.2
unnamed: R3.1, U$3.3
unnamed: R5.1, U$3.5
unnamed: R6.1, U$3.6
unnamed: R7.1, U$3.7
unnamed: R1.1, U$3.1
unnamed: R4.2, U$5.22 (PWM)
unnamed: R8.1, U$3.8
unnamed: R1.2, U$1.22 (PWM)

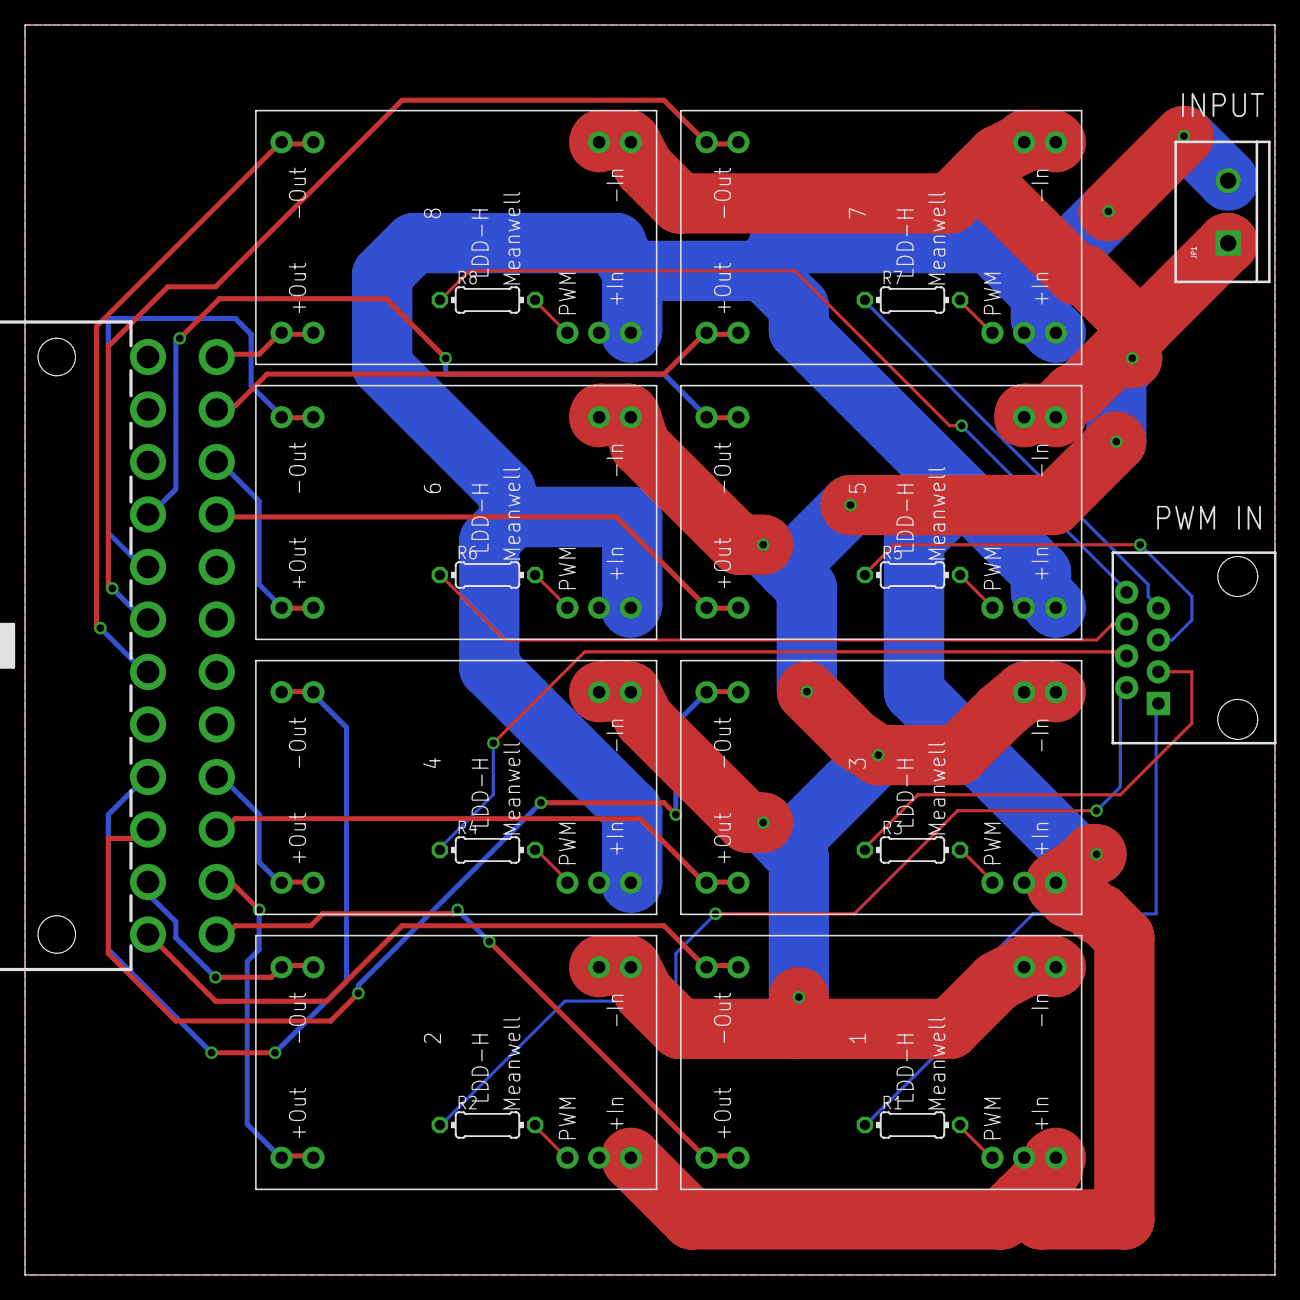
[picture p24: board ARC Lighting v1.0.brd from above]

Board: 2 copper layers, 100.0 x 100.0 mm, 19 parts (0 on the bottom side), 34 nets.
